DasReyxr/RF-Car/readme.md

# RF-Car

A car
## Directory structure
```
├── design
│   ├── KicadDesign
│   │   ├── Design.kicad_pcb
│   │   ├── Design.kicad_pro
│   │   ├── Design.kicad_sch
│   └── Schematic.pdf
├── doc
│   ├── AC
│   ├── ConfigAC.tex
│   ├── Examen1.pdf
│   ├── Examen1.tex
│   └── Tarjeta didáctica de control para tiristores.pdf
├── README.md
├── src
│   └── render.png
├── sim
│   └── SCR.asc
```

- `SCRController.kicad_sch` / `.kicad_pcb` / `.kicad_pro` — KiCad design
- `SCRController.step` — 3D model
- `Tarjeta didáctica de control para tiristores.pdf` — design writeup
- `simulation.asc.txt` — LTspice simulation

3D render

**Photos of the built board — coming soon**

## Files

## Credit
Built as coursework with [DasReyxr](https://github.com/DasReyxr)  and [Kevin Lara](https://github.com/Gyonyu) — original project history in [DasReyxr/HW-Projects](https://github.com/DasReyxr/HW-Projects). This copy is curated separately with a proper writeup and renders.

## Template
```
mkdir code design doc scripts sim src
```

```
tree >> README.md
```
