DasReyxr/RF-Car/design/TX_Hand/readme.md

# Log File
## 6-29-26
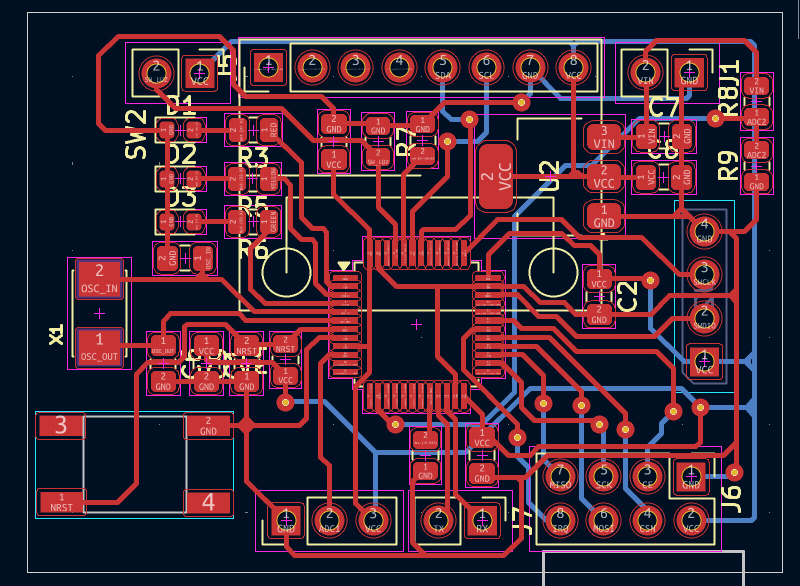
[picture p1: design/TX_Hand/src/readme/image-1.png]

## 6-29-26
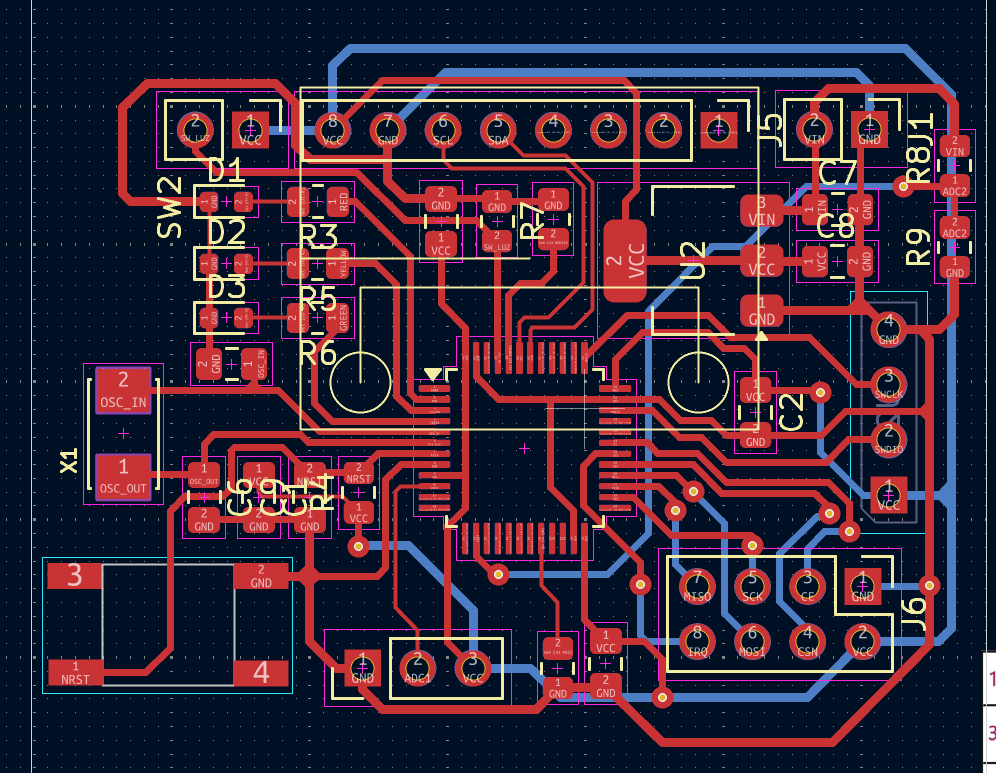
[picture p2: design/TX_Hand/src/readme/image.png]

## 6-29-26
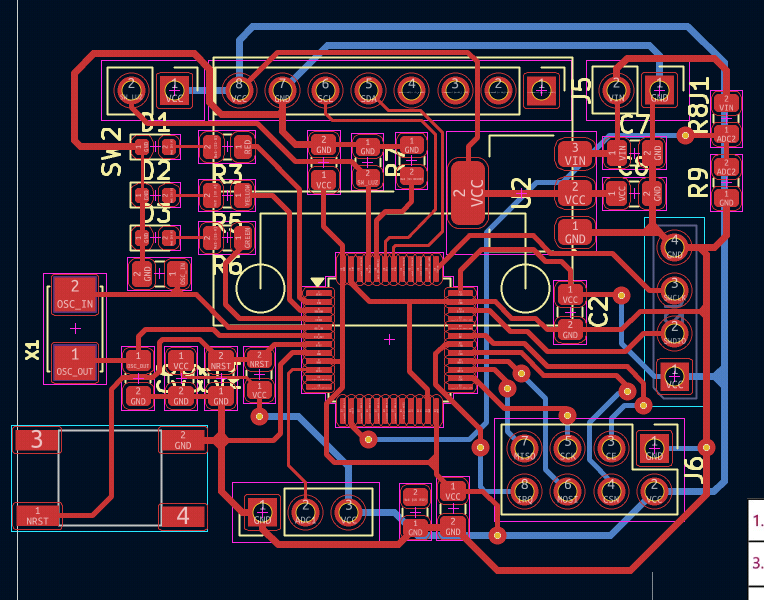
[picture p3: design/TX_Hand/src/readme/6-29-26.png]

## 6-24-26
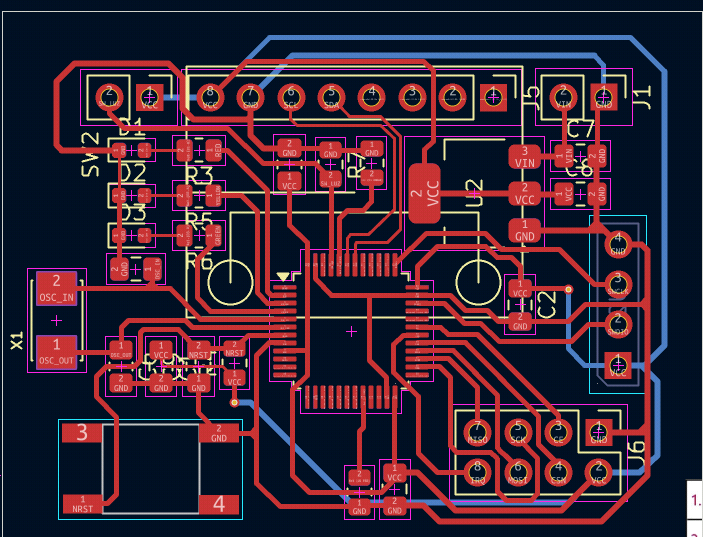
[picture p4: design/TX_Hand/src/readme/6-24-26.png]

## 6-23-26
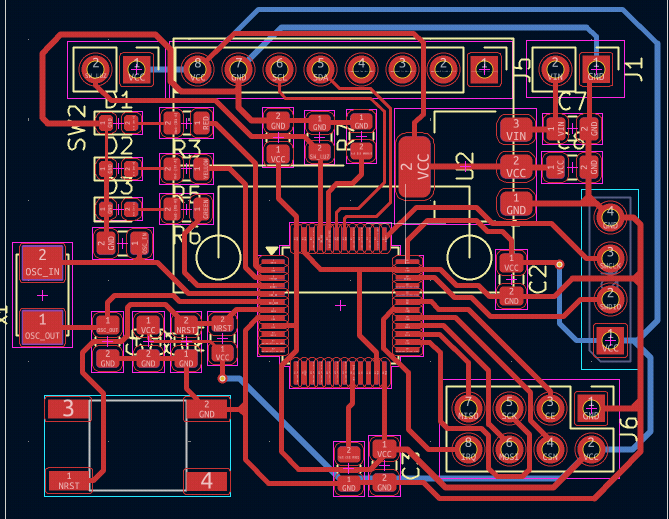
[picture p5: design/TX_Hand/src/readme/6-23-26.png]

# 8-27-26
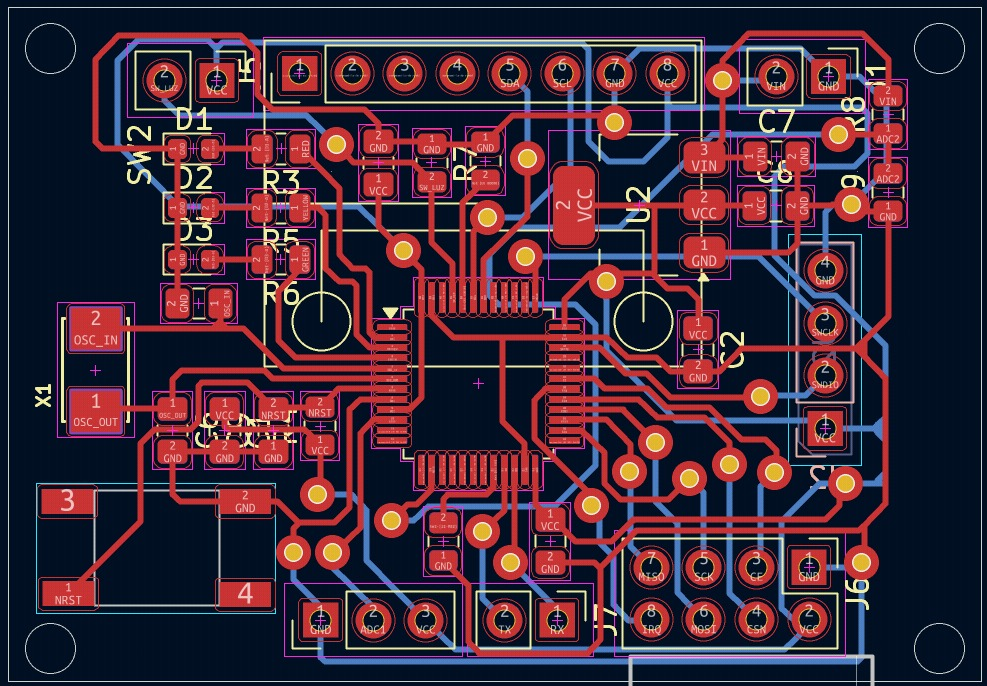
[picture p6: design/TX_Hand/src/readme/image-2.png]


# 10-10-26
- Changed footprints
- Attempt to do it in one layer
- Unconnected VCC and RF mod
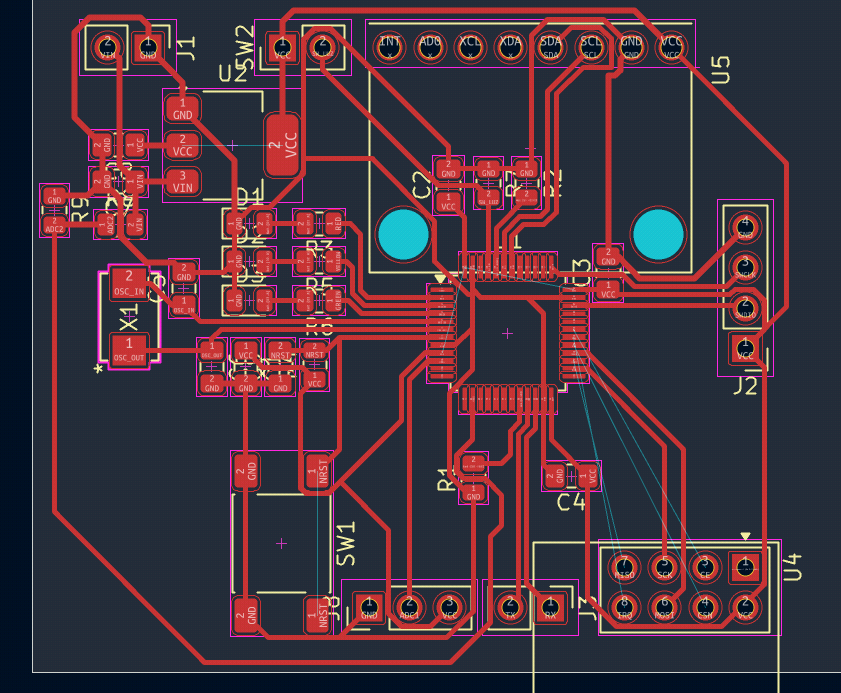
[picture p7: design/TX_Hand/src/readme/image-3.png]

# 10- 11-26
- Autoroute best try (Still not working)
- VCC, SW_Luz and GND not connectedº
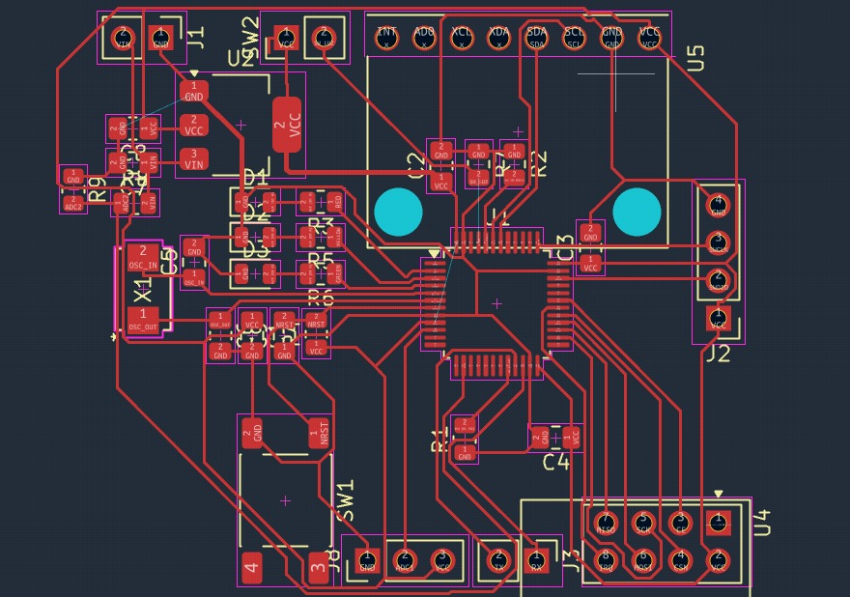
[picture p8: design/TX_Hand/src/readme/image-4.png]
