DasReyxr/RF-Car/code/readme.md

# IOC Config
# RX_Car
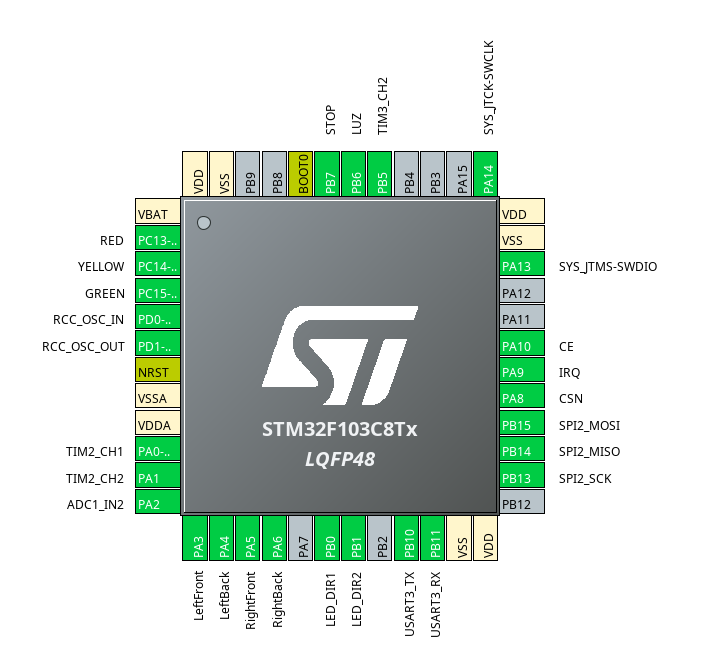
[picture p17: code/src/readme/image.png]

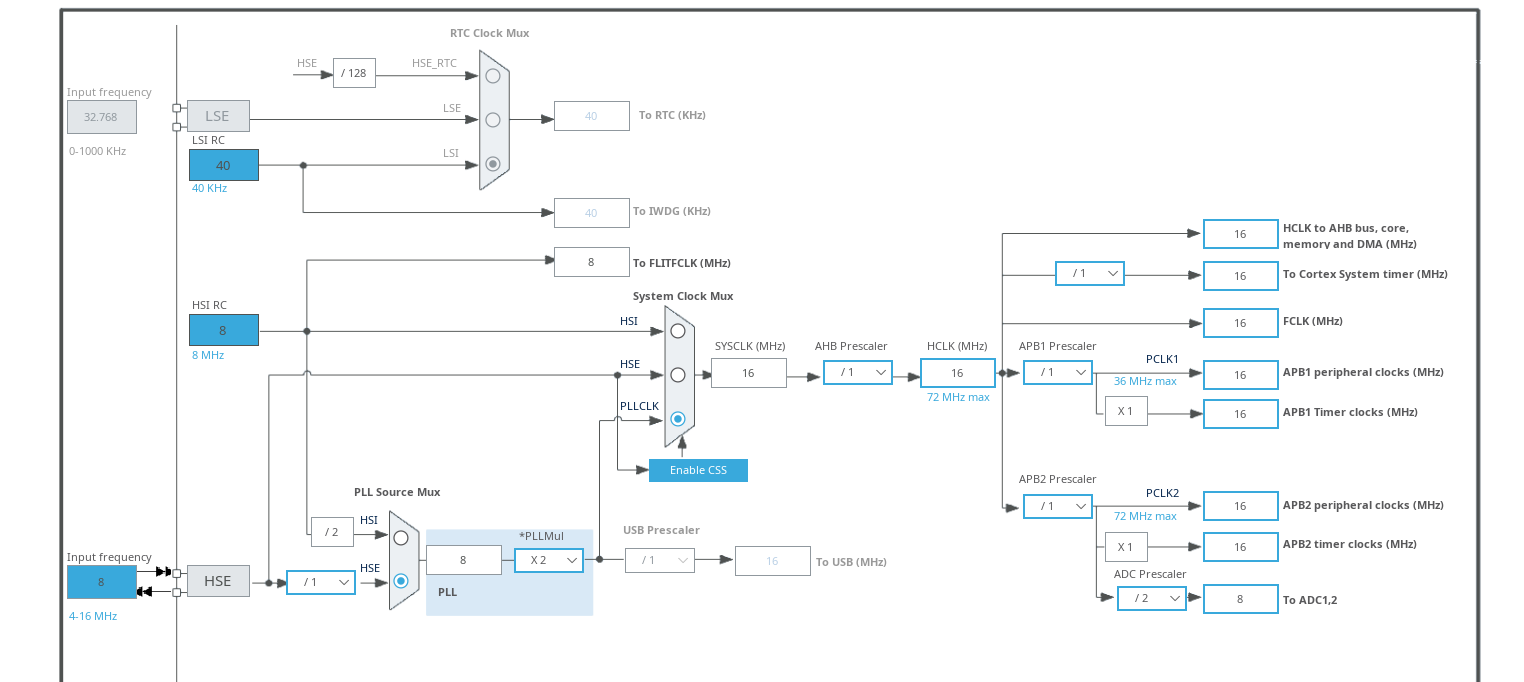
[picture p18: code/src/readme/image-1.png]


# TX_Hand
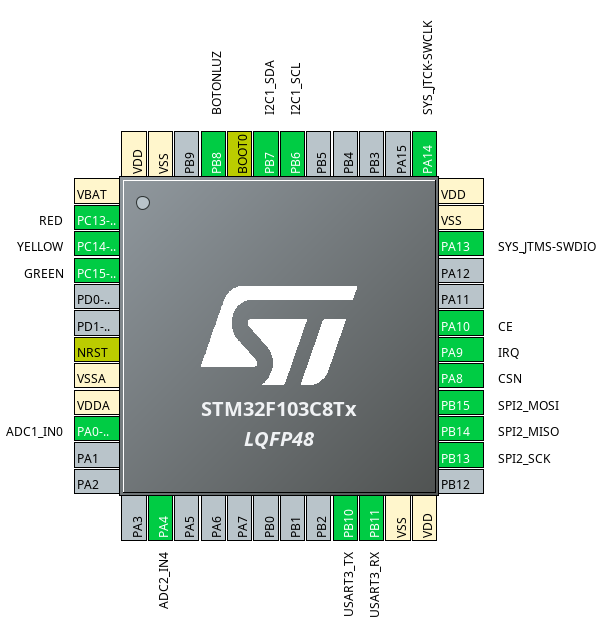
[picture p19: code/src/readme/image-2.png]

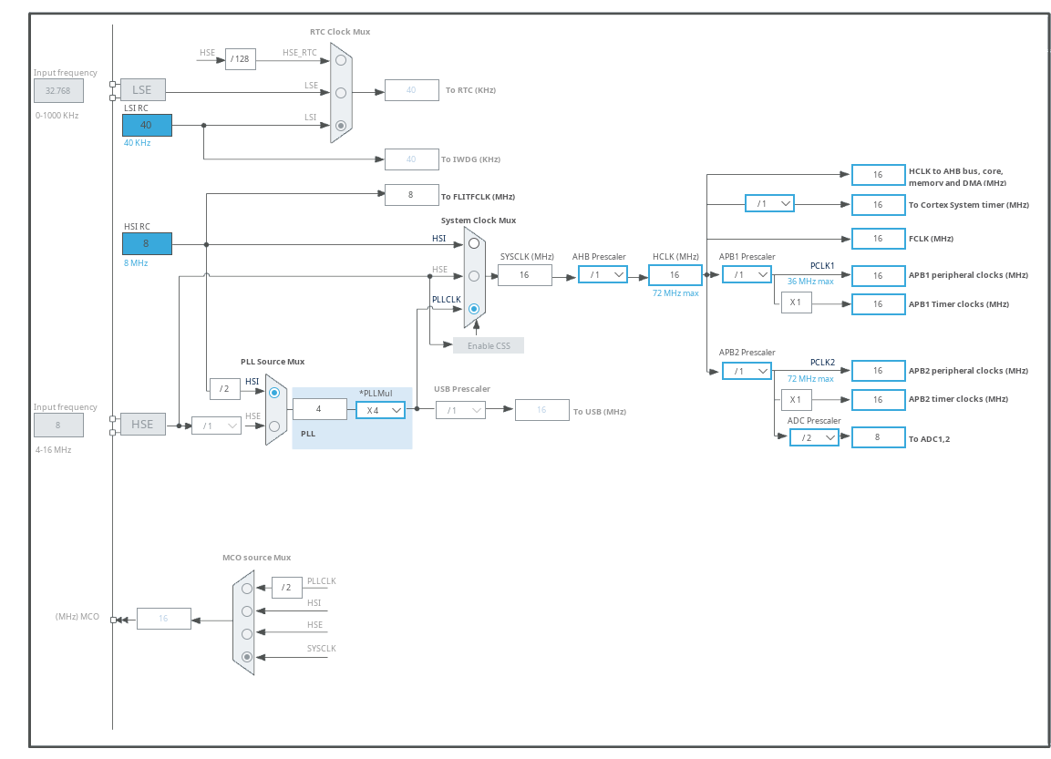
[picture p20: code/src/readme/image-3.png]
