DasReyxr/RF-Car/design/roberikevin/HW_PCB/Librerias/GY-521/GY-521.step

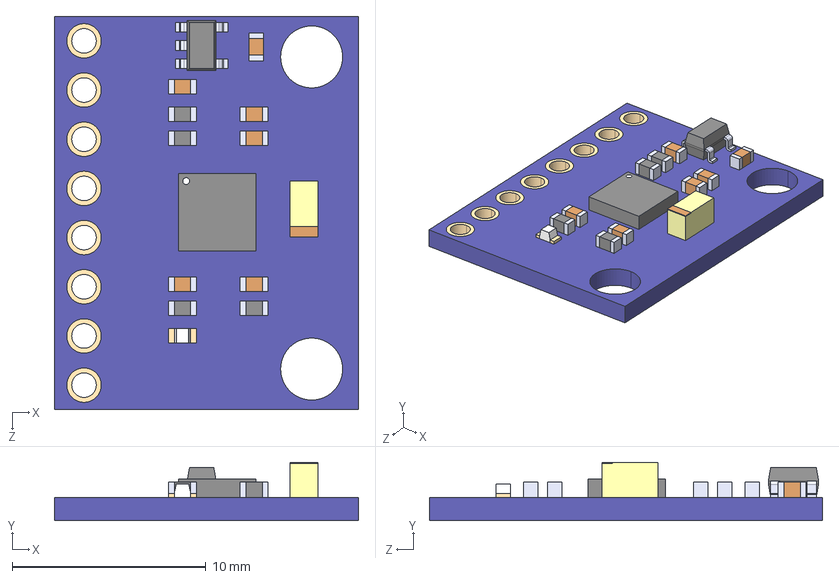
[picture p24: CAD file, 2026-10-10]
design/roberikevin/HW_PCB/Librerias/GY-521/GY-521.step
15.7 x 3.00 x 20.3 mm
