DasReyxr/RF-Car/design/roberikevin/HW_PCB/Librerias/MPU6050/6050_MPU_r0.step

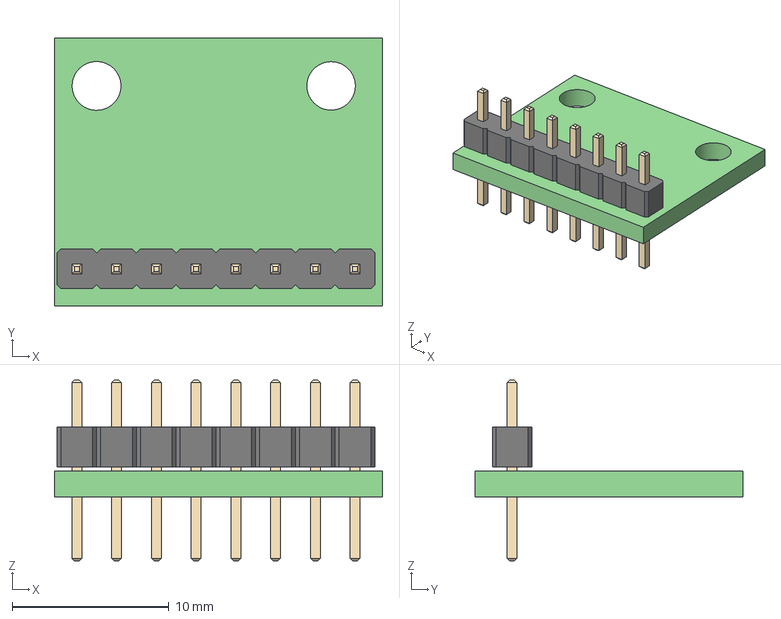
[picture p25: CAD file, 2026-10-10]
design/roberikevin/HW_PCB/Librerias/MPU6050/6050_MPU_r0.step
21.0 x 17.1 x 11.5 mm
