DasReyxr/RF-Car/design/roberikevin/HW_PCB/Librerias/TAJB226K016RNJ/TAJB226K016RNJ.step

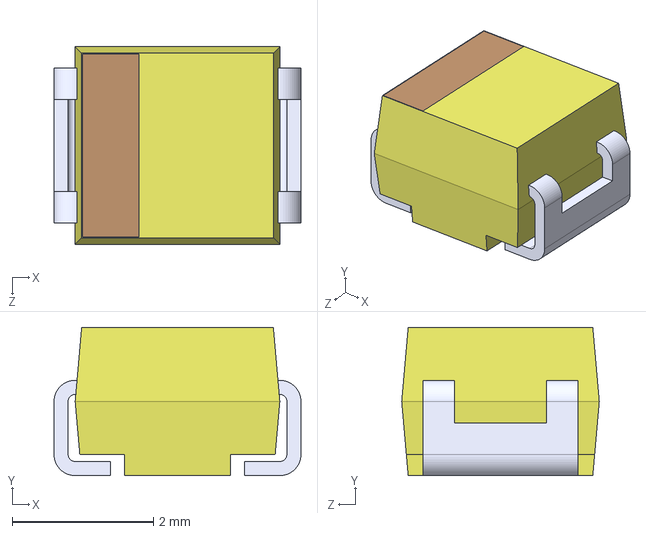
[picture p26: CAD file, 2026-10-10]
design/roberikevin/HW_PCB/Librerias/TAJB226K016RNJ/TAJB226K016RNJ.step
3.50 x 2.10 x 2.80 mm
