DasReyxr/RF-Car/design/roberikevin/HW_PCB/Librerias/TB6612FNG/TB6612FNG.step

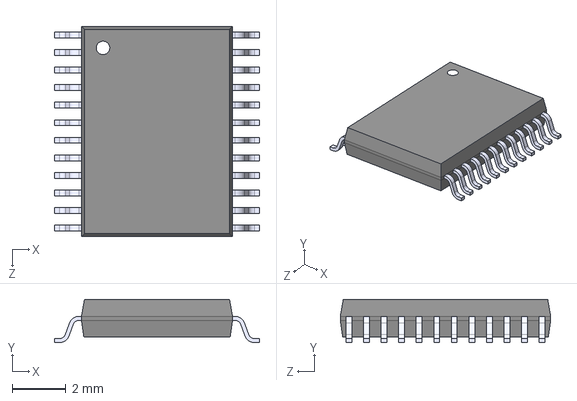
[picture p27: CAD file, 2026-10-10]
design/roberikevin/HW_PCB/Librerias/TB6612FNG/TB6612FNG.step
7.60 x 1.60 x 7.80 mm
