DasReyxr/RF-Car/design/TX_Hand/TX_Hand.kicad_pcb

## KiCad design design/TX_Hand/TX_Hand.kicad_pcb (2026-10-25)

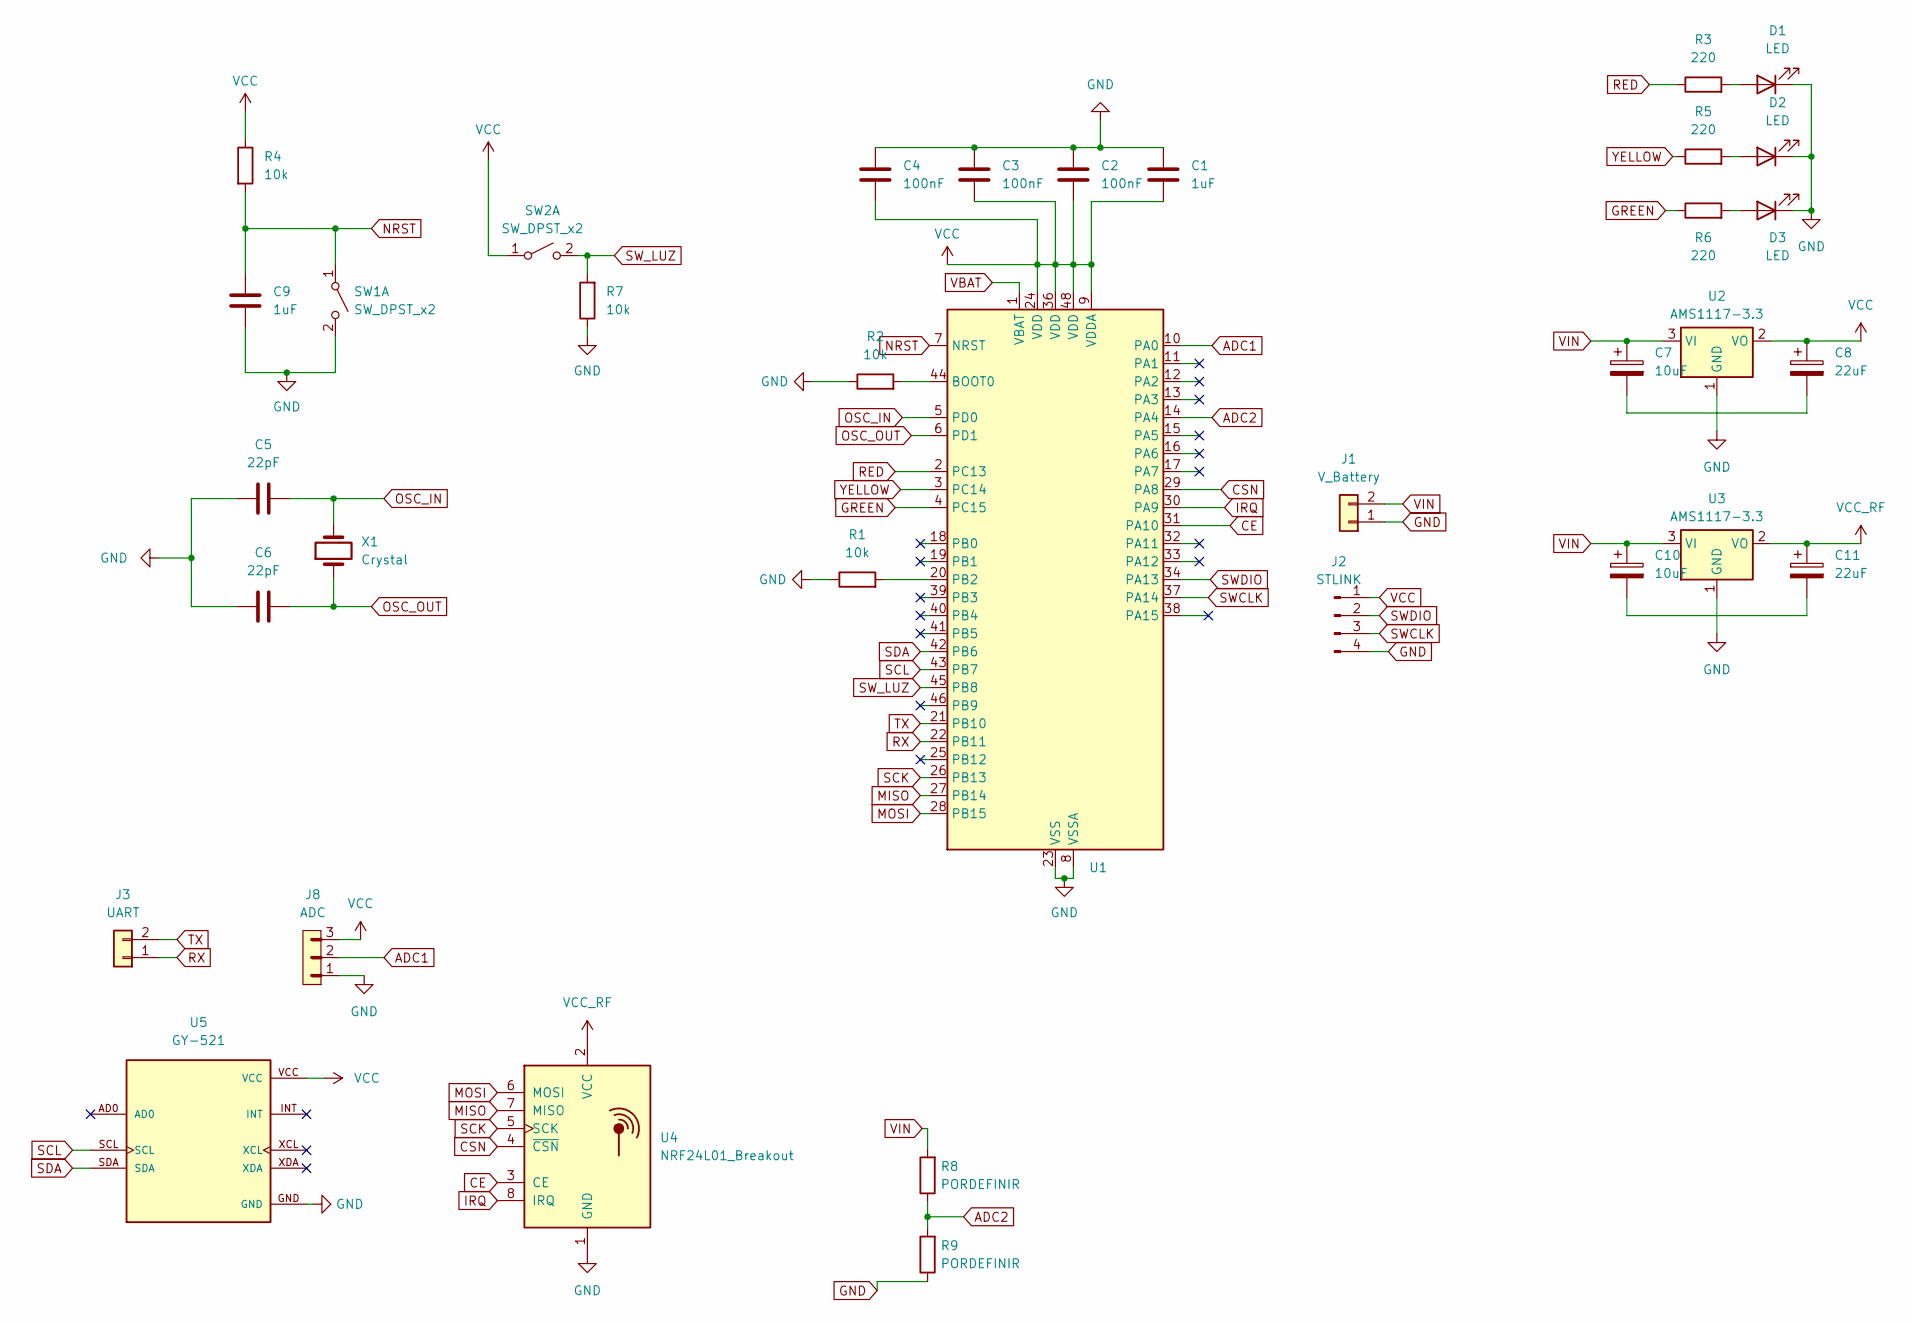
[picture p28: schematic TX_Hand.kicad_sch]

Parts:
C1, C9: 1uF; C_0805_2012Metric_Pad1.18x1.45mm_HandSolder
C2, C3, C4: 100nF; C_0805_2012Metric_Pad1.18x1.45mm_HandSolder
C5, C6: 22pF; C_0805_2012Metric_Pad1.18x1.45mm_HandSolder
C7, C10: 10uF; C_0805_2012Metric_Pad1.18x1.45mm_HandSolder
C8, C11: 22uF; C_0805_2012Metric_Pad1.18x1.45mm_HandSolder
D1, D2, D3: LED; LED_0805_2012Metric
J1: V_Battery; PinHeader_1x02_P2.54mm_Vertical
J2: STLINK; PinHeader_1x04_P2.54mm_Vertical
J3: UART; PinHeader_1x02_P2.54mm_Vertical
J8: ADC; PinHeader_1x03_P2.54mm_Vertical
R1, R2, R4, R7: 10k; R_0805_2012Metric
R3, R5, R6: 220; R_0805_2012Metric
R8, R9: PORDEFINIR; R_0805_2012Metric
SW1: SW_DPST_x2; SW_Push_1P1T_NO_E-Switch_TL3301NxxxxxG
SW2: SW_DPST_x2; PinHeader_1x02_P2.54mm_Vertical
U1: STM32F103C8Tx; LQFP-48_7x7mm_P0.5mm
U2, U3: AMS1117-3.3; SOT-223-3_TabPin2
U4: NRF24L01_Breakout; nRF24L01_Breakout
U5: GY-521; MODULE_GY-521; PARTREV NA
X1: Crystal; XTAL_NX5032_NDK

Connections:
ADC1: J8.2, U1.10 (PA0)
ADC2: R8.1, R9.2, U1.14 (PA4)
CE: U1.31 (PA10), U4.3 (CE)
CSN: U1.29 (PA8), U4.4 (~CSN)
GND: C1.2, C2.2, C3.2, C4.2, C5.2, C6.2, C9.1, D1.1 (K), D2.1 (K), D3.1 (K), J1.1, J2.4, J8.1, R1.1, R2.1, R7.1, R9.1, SW1.2 (B), U1.8 (VSSA), U1.23 (VSS), U1.35 (VSS), U1.47 (VSS), U2.1 (GND), U3.1 (GND), U4.1 (GND), U5.GND
GREEN: R6.1, U1.4 (PC15)
IRQ: U1.30 (PA9), U4.8 (IRQ)
MISO: U1.27 (PB14), U4.7 (MISO)
MOSI: U1.28 (PB15), U4.6 (MOSI)
NRST: C9.2, R4.2, SW1.1 (A), U1.7 (NRST)
unnamed: C7.2, C8.2
unnamed: C10.2, C11.2
unnamed: D1.2 (A), R3.2
unnamed: D2.2 (A), R5.2
unnamed: D3.2 (A), R6.2
unnamed: R2.2, U1.44 (BOOT0)
unnamed: R1.2, U1.20 (PB2)
OSC_IN: C5.1, U1.5 (PD0), X1.2
OSC_OUT: C6.1, U1.6 (PD1), X1.1
RED: R3.1, U1.2 (PC13)
RX: J3.1, U1.22 (PB11)
SCK: U1.26 (PB13), U4.5 (SCK)
SCL: U1.43 (PB7), U5.SCL
SDA: U1.42 (PB6), U5.SDA
SWCLK: J2.3, U1.37 (PA14)
SWDIO: J2.2, U1.34 (PA13)
SW_LUZ: R7.2, SW2.2 (B), U1.45 (PB8)
TX: J3.2, U1.21 (PB10)
VBAT: U1.1 (VBAT)
VCC: C1.1, C2.1, C3.1, C4.1, C8.1, J2.1, J8.3, R4.1, SW2.1 (A), U1.9 (VDDA), U1.24 (VDD), U1.36 (VDD), U1.48 (VDD), U2.2 (VO), U5.VCC
VCC_RF: C11.1, U3.2 (VO), U4.2 (VCC)
VIN: C7.1, C10.1, J1.2, R8.2, U2.3 (VI), U3.3 (VI)
YELLOW: R5.1, U1.3 (PC14)

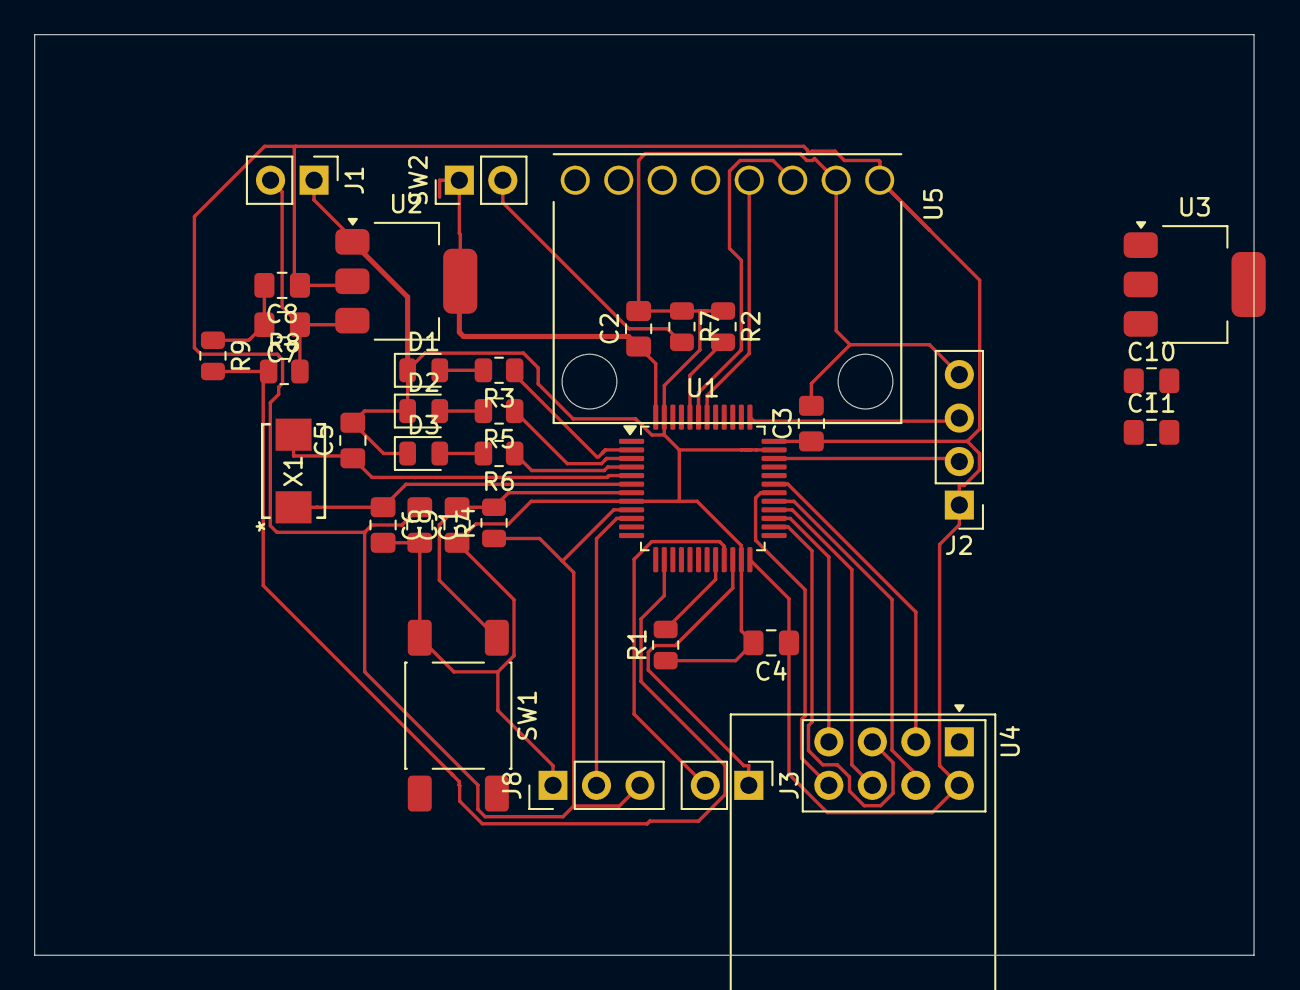
[picture p29: board TX_Hand.kicad_pcb from above]

Board: 2 copper layers, 71.2 x 53.8 mm, 35 parts (0 on the bottom side), 32 nets.
