DasReyxr/RF-Car/design/roberikevin/HW_PCB/CAR/carro_preliminar/carro_preliminar.kicad_pcb

## KiCad design design/roberikevin/HW_PCB/CAR/carro_preliminar/carro_preliminar.kicad_pcb (2026-10-10)

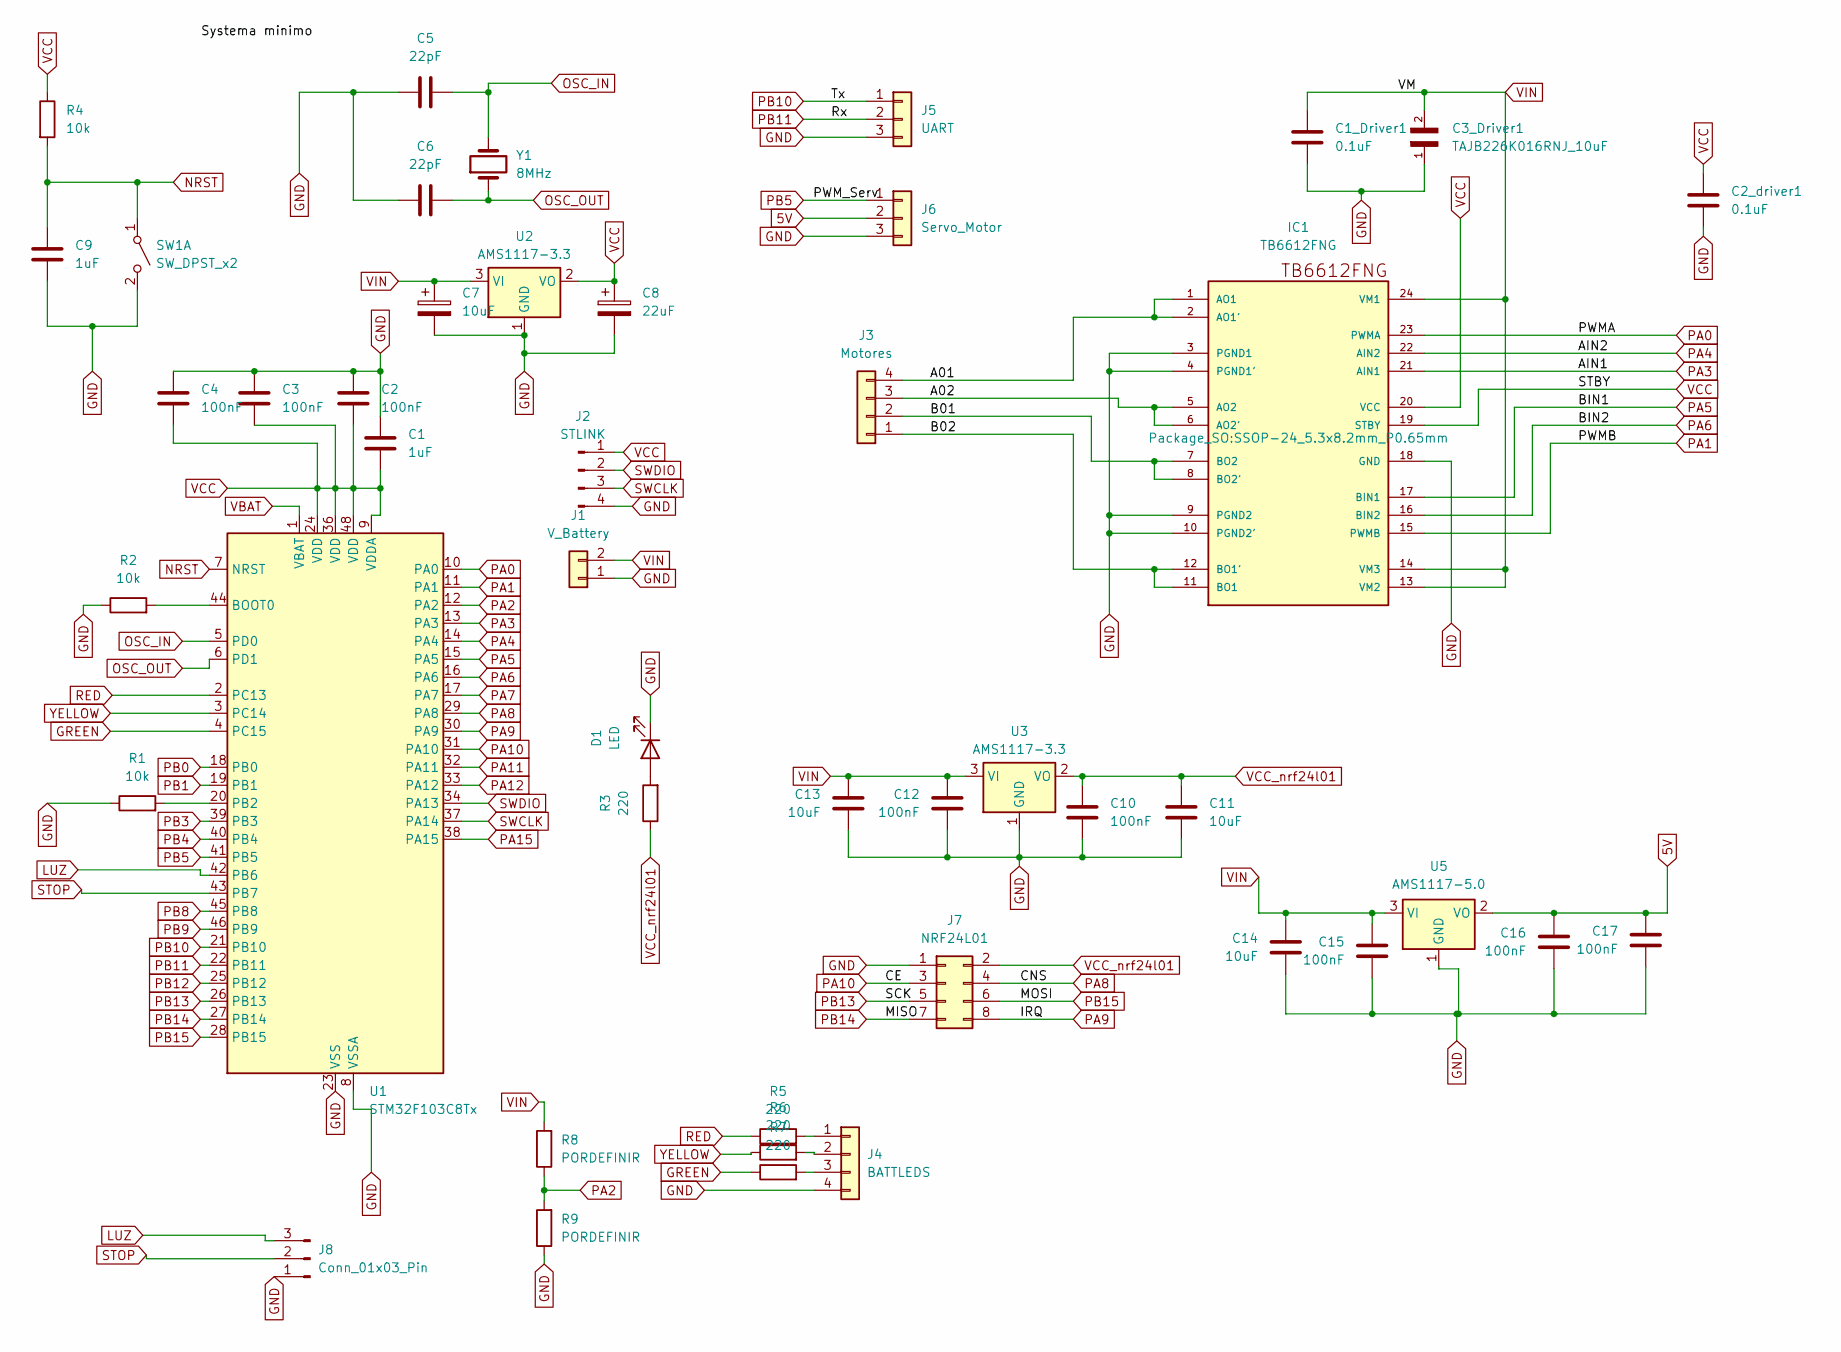
[picture p30: schematic carro_preliminar.kicad_sch]

Parts:
C1: 1uF; C_0805_2012Metric
C1_Driver1, C2_driver1: 0.1uF; C_0805_2012Metric
C2, C3, C4, C10, C12, C15, C16, C17: 100nF; C_0805_2012Metric_Pad1.18x1.45mm_HandSolder
C3_Driver1: TAJB226K016RNJ_10uF; CAPPC3528X210N; DigiKey_Part_Number 478-1682-1-ND
C5, C6: 22pF; C_0805_2012Metric_Pad1.18x1.45mm_HandSolder
C7, C11, C13, C14: 10uF; C_0805_2012Metric_Pad1.18x1.45mm_HandSolder
C8: 22uF; C_0805_2012Metric_Pad1.18x1.45mm_HandSolder
C9: 1uF; C_0805_2012Metric_Pad1.18x1.45mm_HandSolder
D1: LED; LED_0603_1608Metric
IC1: TB6612FNG; SSOP-24_5.3x8.2mm_P0.65mm
J1: V_Battery; PinHeader_1x02_P2.54mm_Vertical
J2: STLINK; PinHeader_1x04_P2.54mm_Vertical
J3: Motores; PinHeader_1x04_P2.54mm_Vertical
J4: BATTLEDS; PinHeader_1x04_P2.54mm_Vertical
J5: UART; PinHeader_1x03_P2.54mm_Vertical
J6: Servo_Motor; PinHeader_1x03_P2.54mm_Vertical
J7: NRF24L01; PinHeader_2x04_P2.54mm_Vertical
J8: Conn_01x03_Pin; PinHeader_1x03_P2.54mm_Vertical
R1, R2, R4: 10k; R_0805_2012Metric
R3, R5, R6, R7: 220; R_0805_2012Metric
R8, R9: PORDEFINIR; R_0805_2012Metric
SW1: SW_DPST_x2; Untitled
U1: STM32F103C8Tx; LQFP-48_7x7mm_P0.5mm
U2, U3: AMS1117-3.3; SOT-223-3_TabPin2
U5: AMS1117-5.0; SOT-223-3_TabPin2
Y1: 8MHz; XTAL_NX5032GA-8.000M-STD-CSU-1

Connections:
5V: C16.1, C17.1, J6.2, U5.2 (VO)
/A01: IC1.1 (AO1), IC1.2 (AO1'), J3.4
/A02: IC1.5 (AO2), IC1.6 (AO2'), J3.3
/B01: IC1.7 (BO2), IC1.8 (BO2'), J3.2
/B02: IC1.11 (BO1), IC1.12 (BO1'), J3.1
GND: C1.2, C1_Driver1.2, C2.2, C2_driver1.2, C3.2, C3_Driver1.1, C4.2, C5.2, C6.2, C7.2, C8.2, C9.1, C10.2, C11.2, C12.2, C13.2, C14.2, C15.2, C16.2, C17.2, D1.1 (K), IC1.3 (PGND1), IC1.4 (PGND1'), IC1.9 (PGND2), IC1.10 (PGND2'), IC1.18 (GND), J1.1, J2.4, J4.4, J5.3, J6.3, J7.1, J8.1, R1.1, R2.1, R9.1, SW1.2 (B), U1.8 (VSSA), U1.23 (VSS), U1.35 (VSS), U1.47 (VSS), U2.1 (GND), U3.1 (GND), U5.1 (GND)
GREEN: R7.1, U1.4 (PC15)
LUZ: J8.3, U1.42 (PB6)
NRST: C9.2, R4.2, SW1.1 (A), U1.7 (NRST)
unnamed: D1.2 (A), R3.2
unnamed: J4.1, R5.2
unnamed: J4.2, R6.2
unnamed: J4.3, R7.2
unnamed: R2.2, U1.44 (BOOT0)
unnamed: R1.2, U1.20 (PB2)
OSC_IN: C5.1, U1.5 (PD0), Y1.2
OSC_OUT: C6.1, U1.6 (PD1), Y1.1
PA0: IC1.23 (PWMA), U1.10 (PA0)
PA1: IC1.15 (PWMB), U1.11 (PA1)
PA2: R8.1, R9.2, U1.12 (PA2)
PA3: IC1.21 (AIN1), U1.13 (PA3)
PA4: IC1.22 (AIN2), U1.14 (PA4)
PA5: IC1.17 (BIN1), U1.15 (PA5)
PA6: IC1.16 (BIN2), U1.16 (PA6)
PA7: U1.17 (PA7)
PA8: J7.4, U1.29 (PA8)
PA9: J7.8, U1.30 (PA9)
PA10: J7.3, U1.31 (PA10)
PA11: U1.32 (PA11)
PA12: U1.33 (PA12)
PA15: U1.38 (PA15)
PB0: U1.18 (PB0)
PB1: U1.19 (PB1)
PB3: U1.39 (PB3)
PB4: U1.40 (PB4)
PB5: J6.1, U1.41 (PB5)
PB8: U1.45 (PB8)
PB9: U1.46 (PB9)
PB10: J5.1, U1.21 (PB10)
PB11: J5.2, U1.22 (PB11)
PB12: U1.25 (PB12)
PB13: J7.5, U1.26 (PB13)
PB14: J7.7, U1.27 (PB14)
PB15: J7.6, U1.28 (PB15)
RED: R5.1, U1.2 (PC13)
STOP: J8.2, U1.43 (PB7)
SWCLK: J2.3, U1.37 (PA14)
SWDIO: J2.2, U1.34 (PA13)
VBAT: U1.1 (VBAT)
VCC: C1.1, C2.1, C2_driver1.1, C3.1, C4.1, C8.1, IC1.19 (STBY), IC1.20 (VCC), J2.1, R4.1, U1.9 (VDDA), U1.24 (VDD), U1.36 (VDD), U1.48 (VDD), U2.2 (VO)
VCC_nrf24l01: C10.1, C11.1, J7.2, R3.1, U3.2 (VO)
VIN: C1_Driver1.1, C3_Driver1.2, C7.1, C12.1, C13.1, C14.1, C15.1, IC1.13 (VM2), IC1.14 (VM3), IC1.24 (VM1), J1.2, R8.2, U2.3 (VI), U3.3 (VI), U5.3 (VI)
YELLOW: R6.1, U1.3 (PC14)

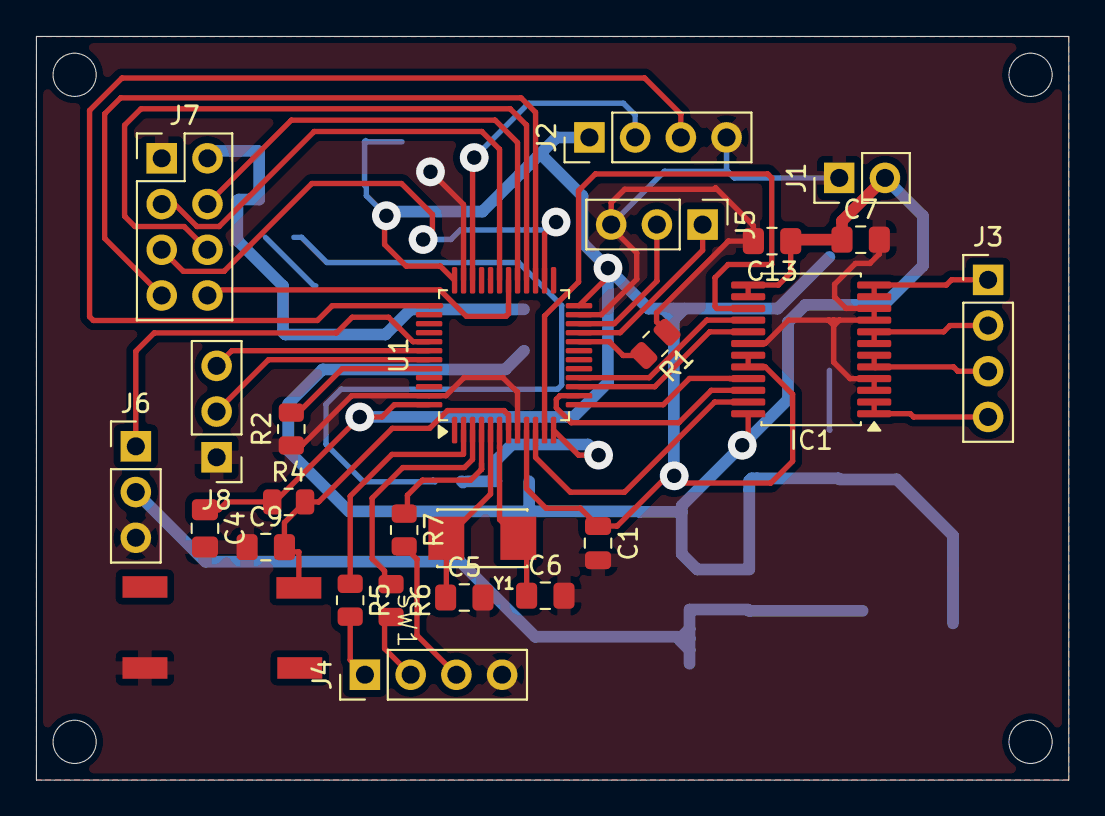
[picture p31: board carro_preliminar.kicad_pcb from above]

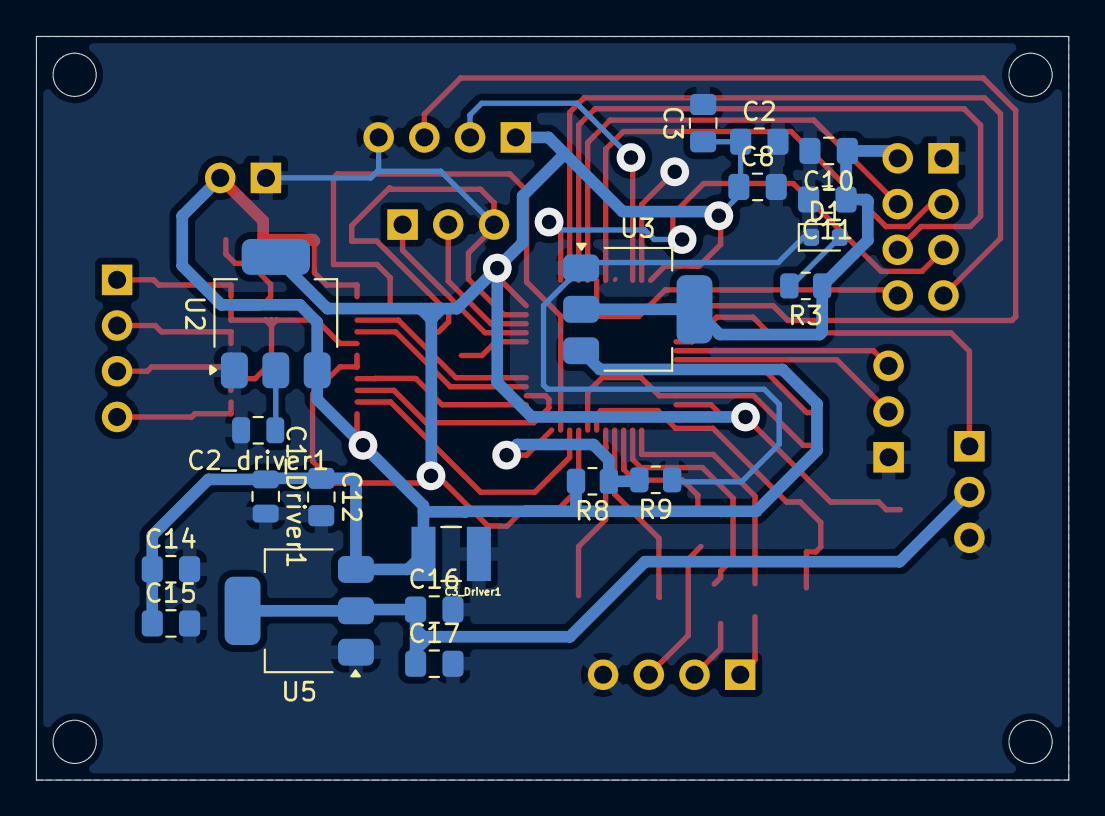
[picture p32: board carro_preliminar.kicad_pcb from below]

Board: 2 copper layers, 57.4 x 41.3 mm, 45 parts (20 on the bottom side), 41 nets.
