DasReyxr/RF-Car/design/roberikevin/HW_PCB/SYS_MIN/Blue_pill/Blue_pill.kicad_pcb

## KiCad design design/roberikevin/HW_PCB/SYS_MIN/Blue_pill/Blue_pill.kicad_pcb (2026-10-10)

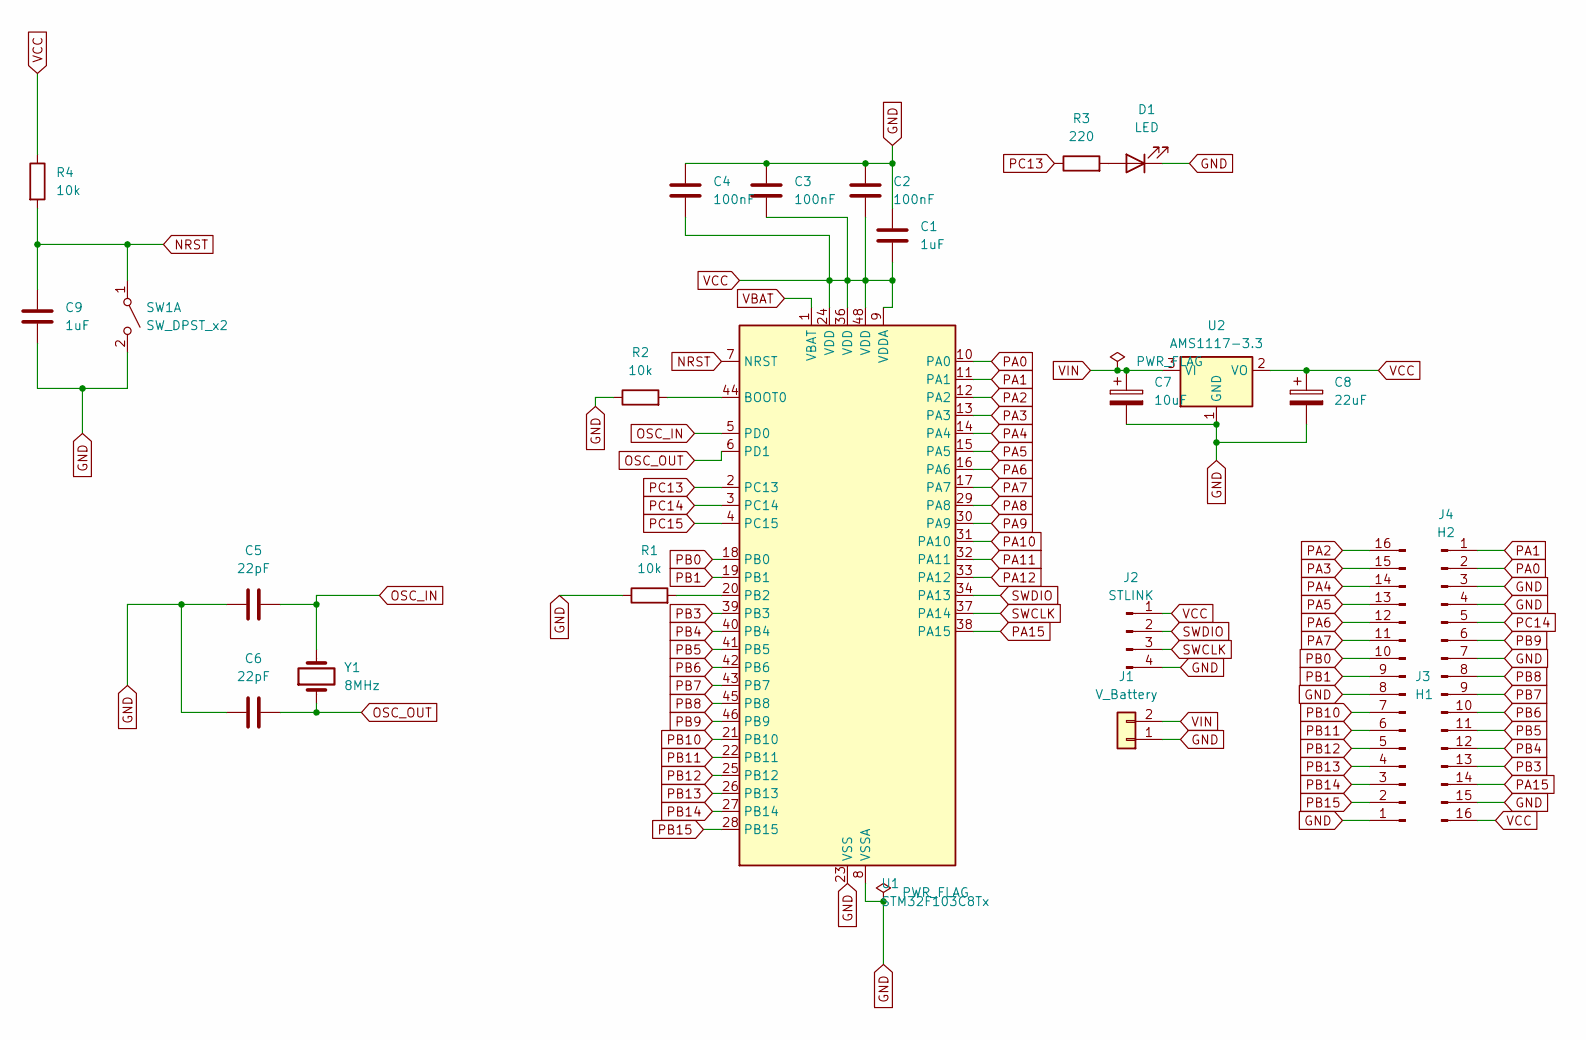
[picture p33: schematic Blue_pill.kicad_sch]

Parts:
C1: 1uF; C_0805_2012Metric
C2, C3, C4: 100nF; C_0805_2012Metric_Pad1.18x1.45mm_HandSolder
C5, C6: 22pF; C_0805_2012Metric_Pad1.18x1.45mm_HandSolder
C7: 10uF; C_0805_2012Metric_Pad1.18x1.45mm_HandSolder
C8: 22uF; C_0805_2012Metric_Pad1.18x1.45mm_HandSolder
C9: 1uF; C_0805_2012Metric_Pad1.18x1.45mm_HandSolder
D1: LED; LED_0603_1608Metric
J1: V_Battery; PinHeader_1x02_P2.54mm_Vertical
J2: STLINK; PinHeader_1x04_P2.54mm_Vertical
J3: H1; PinHeader_1x16_P2.54mm_Vertical
J4: H2; PinHeader_1x16_P2.54mm_Vertical
R1, R2, R4: 10k; R_0805_2012Metric
R3: 220; R_0805_2012Metric
SW1: SW_DPST_x2; Untitled
U1: STM32F103C8Tx; LQFP-48_7x7mm_P0.5mm
U2: AMS1117-3.3; SOT-223-3_TabPin2
Y1: 8MHz; Crystal_SMD_EuroQuartz_MQ2-2Pin_7.0x5.0mm

Connections:
GND: C1.2, C2.2, C3.2, C4.2, C5.2, C6.2, C7.2, C8.2, C9.1, D1.1 (K), J1.1, J2.4, J3.1, J3.8, J4.3, J4.4, J4.7, J4.15, R1.1, R2.1, SW1.2 (B), U1.8 (VSSA), U1.23 (VSS), U1.35 (VSS), U1.47 (VSS), U2.1 (GND)
NRST: C9.2, R4.2, SW1.1 (A), U1.7 (NRST)
unnamed: D1.2 (A), R3.2
unnamed: R2.2, U1.44 (BOOT0)
unnamed: R1.2, U1.20 (PB2)
OSC_IN: C5.1, U1.5 (PD0), Y1.2
OSC_OUT: C6.1, U1.6 (PD1), Y1.1
PA0: J4.2, U1.10 (PA0)
PA1: J4.1, U1.11 (PA1)
PA2: J3.16, U1.12 (PA2)
PA3: J3.15, U1.13 (PA3)
PA4: J3.14, U1.14 (PA4)
PA5: J3.13, U1.15 (PA5)
PA6: J3.12, U1.16 (PA6)
PA7: J3.11, U1.17 (PA7)
PA8: U1.29 (PA8)
PA9: U1.30 (PA9)
PA10: U1.31 (PA10)
PA11: U1.32 (PA11)
PA12: U1.33 (PA12)
PA15: J4.14, U1.38 (PA15)
PB0: J3.10, U1.18 (PB0)
PB1: J3.9, U1.19 (PB1)
PB3: J4.13, U1.39 (PB3)
PB4: J4.12, U1.40 (PB4)
PB5: J4.11, U1.41 (PB5)
PB6: J4.10, U1.42 (PB6)
PB7: J4.9, U1.43 (PB7)
PB8: J4.8, U1.45 (PB8)
PB9: J4.6, U1.46 (PB9)
PB10: J3.7, U1.21 (PB10)
PB11: J3.6, U1.22 (PB11)
PB12: J3.5, U1.25 (PB12)
PB13: J3.4, U1.26 (PB13)
PB14: J3.3, U1.27 (PB14)
PB15: J3.2, U1.28 (PB15)
PC13: R3.1, U1.2 (PC13)
PC14: J4.5, U1.3 (PC14)
PC15: U1.4 (PC15)
SWCLK: J2.3, U1.37 (PA14)
SWDIO: J2.2, U1.34 (PA13)
VBAT: U1.1 (VBAT)
VCC: C1.1, C2.1, C3.1, C4.1, C8.1, J2.1, J4.16, R4.1, U1.9 (VDDA), U1.24 (VDD), U1.36 (VDD), U1.48 (VDD), U2.2 (VO)
VIN: C7.1, J1.2, U2.3 (VI)

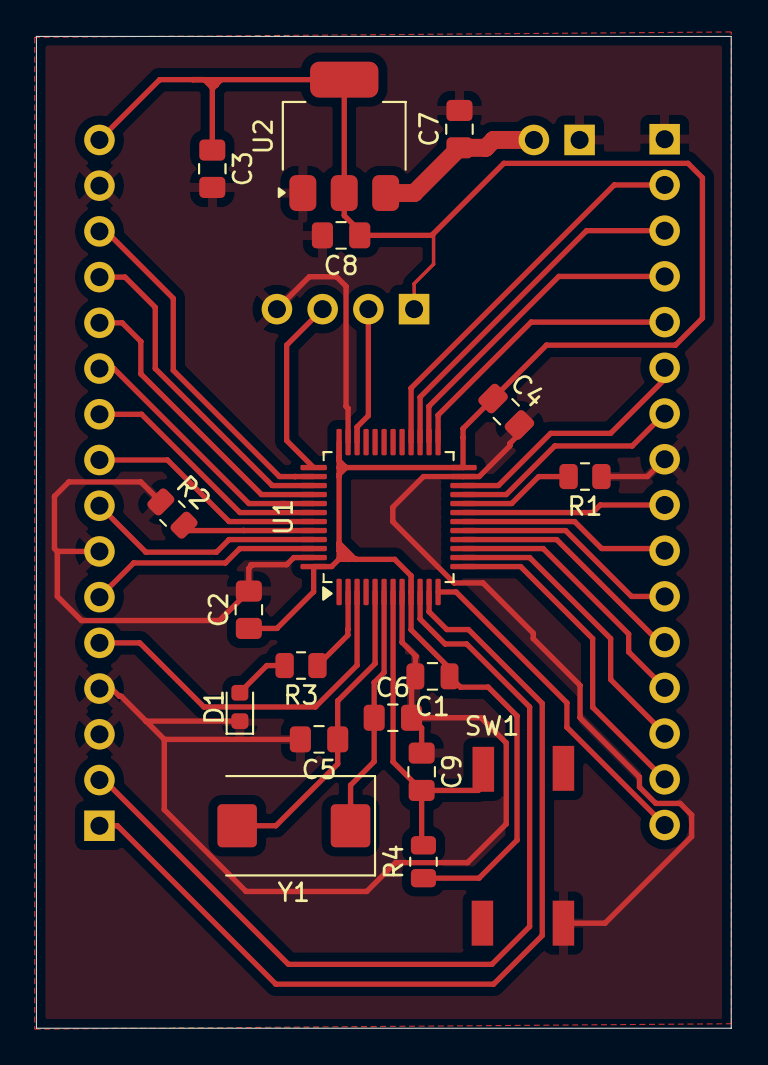
[picture p34: board Blue_pill.kicad_pcb from above]

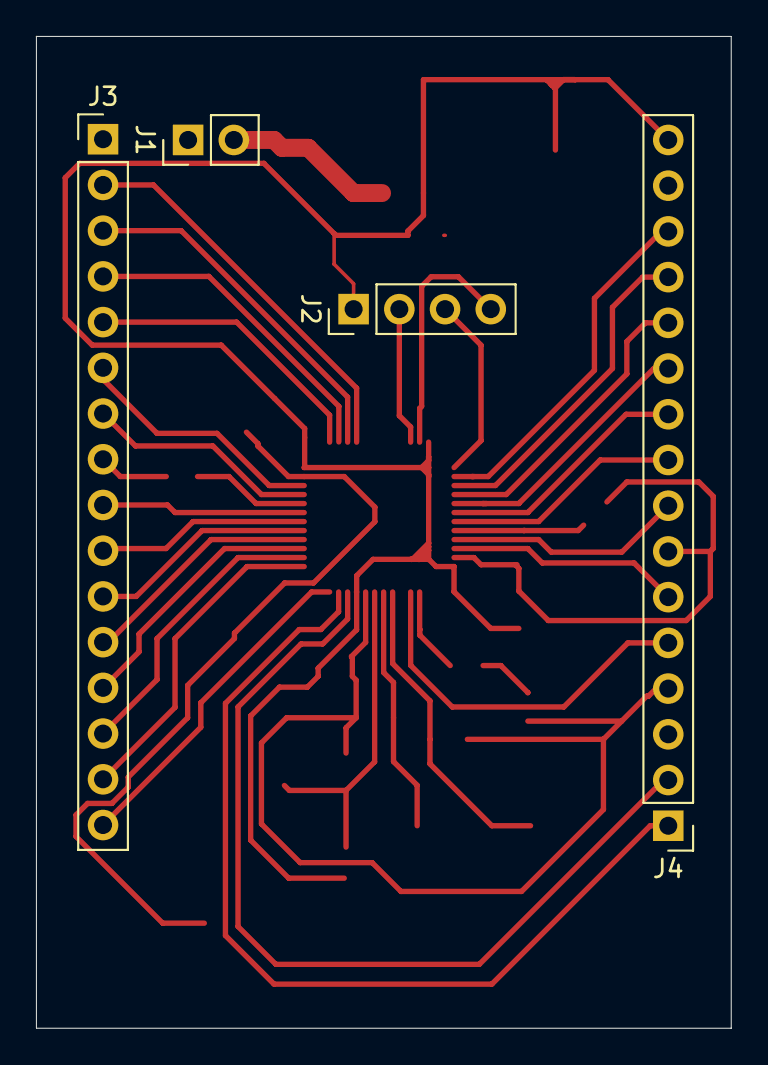
[picture p35: board Blue_pill.kicad_pcb from below]

Board: 2 copper layers, 38.6 x 55.1 mm, 22 parts (4 on the bottom side), 37 nets.
