DasReyxr/RF-Car/design/roberikevin/HW_PCB/CAR/driver_puenteH/driver_puenteH.kicad_pcb

## KiCad design design/roberikevin/HW_PCB/CAR/driver_puenteH/driver_puenteH.kicad_pcb (2026-10-10)

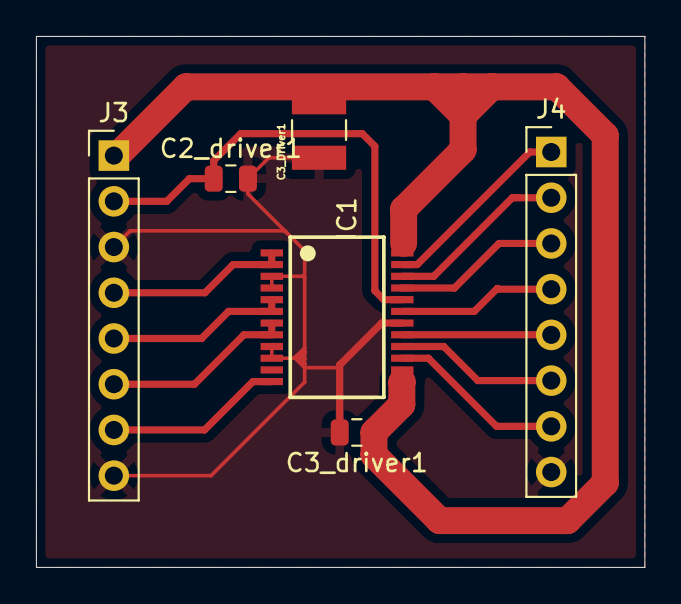
[picture p36: board driver_puenteH.kicad_pcb from above]

Board: 2 copper layers, 33.8 x 29.5 mm, 6 parts (0 on the bottom side), 14 nets.

Parts:
C2_driver1: 0.1uF; C_0805_2012Metric
C3_Driver1: TAJB226K016RNJ_10uF; CAPPC3528X210N
C3_driver1: 10uF; C_0805_2012Metric
IC1: TB6612FNG; SSOP24
J3: Puente H; PinHeader_1x08_P2.54mm_Vertical
J4: Puente_H2; PinHeader_1x08_P2.54mm_Vertical

Connections:
/A01: IC1.1 (AO1), IC1.2 (AO1'), J3.4
/A02: IC1.5 (AO2), IC1.6 (AO2'), J3.5
/AIN1: IC1.21 (AIN1), J4.3
/AIN2: IC1.22 (AIN2), J4.2
/B01: IC1.7 (BO2), IC1.8 (BO2'), J3.6
/B02: IC1.11 (BO1), IC1.12 (BO1'), J3.7
/BIN1: IC1.17 (BIN1), J4.5
/BIN2: IC1.16 (BIN2), J4.6
/PWMA: IC1.23 (PWMA), J4.1
/PWMB: IC1.15 (PWMB), J4.7
/STBY: IC1.19 (STBY), J4.4
/VM: C3_Driver1.2, C3_driver1.1, IC1.13 (VM2), IC1.14 (VM3), IC1.24 (VM1), J3.1
GND: C2_driver1.2, C3_Driver1.1, C3_driver1.2, IC1.3 (PGND1), IC1.4 (PGND1'), IC1.9 (PGND2), IC1.10 (PGND2'), IC1.18 (GND), J3.3, J3.8, J4.8
VCC: C2_driver1.1, IC1.20 (VCC), J3.2
