DasReyxr/RF-Car/code/RX_Car/Core/Src/main.c

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
/* Includes ------------------------------------------------------------------*/
#include "main.h"

/* USER CODE BEGIN Includes */
#include "NRF24.h"
#include "NRF24_reg_addresses.h"
#include "conf.h"
#include <stdio.h>

/* USER CODE END Includes */

/* USER CODE BEGIN PD */
typedef struct {
  uint8_t cmd;
  uint8_t speed;

  float angle;
} RF_Data;

#define PLD_SIZE sizeof(RF_Data)
/* USER CODE END PD */

ADC_HandleTypeDef hadc1;

SPI_HandleTypeDef hspi2;

TIM_HandleTypeDef htim2;
TIM_HandleTypeDef htim3;

UART_HandleTypeDef huart3;

/* USER CODE BEGIN PV */

RF_Data rxData;
uint8_t dataRx[sizeof(RF_Data)];
uint8_t addrRx[5]="juan1";
uint16_t adc_val;
uint16_t batery_val;
/* USER CODE END PV */

void SystemClock_Config(void);
static void MX_GPIO_Init(void);
static void MX_SPI2_Init(void);
static void MX_TIM2_Init(void);
static void MX_TIM3_Init(void);
static void MX_ADC1_Init(void);
static void MX_USART3_UART_Init(void);
/**
  * @brief  The application entry point.
  * @retval int
  */
int main(void)
{

  /* MCU Configuration--------------------------------------------------------*/

  /* Reset of all peripherals, Initializes the Flash interface and the Systick. */
  HAL_Init();

  /* Configure the system clock */
  SystemClock_Config();

  /* Initialize all configured peripherals */
  MX_GPIO_Init();
  MX_SPI2_Init();
  MX_TIM2_Init();
  MX_TIM3_Init();
  MX_ADC1_Init();
  MX_USART3_UART_Init();
  /* USER CODE BEGIN 2 */
  HAL_TIM_PWM_Start(&htim2, TIM_CHANNEL_1); // Start PWM for motor channel 1
  HAL_TIM_PWM_Start(&htim2, TIM_CHANNEL_2); // Start PWM for motor channel 2
  HAL_TIM_PWM_Start(&htim3, TIM_CHANNEL_2); // Start PWM for servo
  csn_high();
  nrf24_init();
  nrf24_tx_pwr(_0dbm );
  nrf24_data_rate(_2mbps);
  nrf24_set_crc(en_crc,_1byte);
  nrf24_set_channel(100);
  nrf24_pipe_pld_size(0,PLD_SIZE);
  //nrf24_open_tx_pipe(addrRx);
  nrf24_open_rx_pipe(0,addrRx);
  nrf24_listen();
  HAL_ADC_Start(&hadc1);




  /* USER CODE END 2 */

  /* Infinite loop */
  /* USER CODE BEGIN WHILE */
  while (1)
  {
    /* USER CODE END WHILE */

    /* USER CODE BEGIN 3 */
    nrf24_listen();
    if(nrf24_data_available()){
        nrf24_receive(dataRx, sizeof(dataRx));
        // Copy received bytes into struct
        memcpy(&rxData, dataRx, sizeof(RF_Data));
        if(rxData.cmd == 0x01)
            CAR_Stop();
            else {
              // --- Direction Motor ---
              if(rxData.cmd == 0x04)      CAR_Back();
              else if(rxData.cmd == 0x02)
            	  CAR_Front();
              uint16_t cast =(uint16_t)rxData.angle;
              __HAL_TIM_SET_COMPARE(&htim3,TIM_CHANNEL_2,cast );
              // --- Speed Motor ---
              CAR_Speed(rxData.speed);
              // -- LED  ---
              if(rxData.cmd == 0x10) GPIOB->ODR ^= (1<<6); // Toggle Light
              }
              /*ADC_BAT*/

              /*UART*/
          /*
          bat = {battery_val}
          cmd = {rxData.cmd}
          speed = {rxData.speed}
          angle = {rxData.angle}
          */
    }



    }



    
  /* USER CODE END 3 */
}

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
