DasReyxr/RF-Car/code/RX_Car/Core/Inc/main.h

#define RED_Pin GPIO_PIN_13
#define RED_GPIO_Port GPIOC
#define YELLOW_Pin GPIO_PIN_14
#define YELLOW_GPIO_Port GPIOC
#define GREEN_Pin GPIO_PIN_15
#define GREEN_GPIO_Port GPIOC
#define LeftFront_Pin GPIO_PIN_3
#define LeftFront_GPIO_Port GPIOA
#define LeftBack_Pin GPIO_PIN_4
#define LeftBack_GPIO_Port GPIOA
#define RightFront_Pin GPIO_PIN_5
#define RightFront_GPIO_Port GPIOA
#define RightBack_Pin GPIO_PIN_6
#define RightBack_GPIO_Port GPIOA
#define LED_DIR1_Pin GPIO_PIN_0
#define LED_DIR1_GPIO_Port GPIOB
#define LED_DIR2_Pin GPIO_PIN_1
#define LED_DIR2_GPIO_Port GPIOB
#define CSN_Pin GPIO_PIN_8
#define CSN_GPIO_Port GPIOA
#define IRQ_Pin GPIO_PIN_9
#define IRQ_GPIO_Port GPIOA
#define CE_Pin GPIO_PIN_10
#define CE_GPIO_Port GPIOA
#define LUZ_Pin GPIO_PIN_6
#define LUZ_GPIO_Port GPIOB
#define STOP_Pin GPIO_PIN_7
#define STOP_GPIO_Port GPIOB
