DasReyxr/RF-Car/code/RX_Car/Core/Src/conf.c

#include "conf.h"

/*
PINOUT
M1 Left
M2 Right

A Peripherals

PA0 PWM2Ch1
PA1 PWM2Ch2


PA3 M1 Front
PA4 M1 Back

PA5 M2 Front
PA6 M2 Back

PB0 LEDs Left
PB1 LEDs Right

PB5 PWM SERVOMOTOR TIMER3

PA8 CSN
PA9 IRQ
PA10 CE

PB[13:15] SPI
PB13 SCK
PB14 MISO
PB15 MOSI

A2 ADC

B10 TX UART
B11 RX UART

PC13 BATRED
PC14 BATYELL
PC15 BATGREEN

PB6 LUZ
PB7 STOP
1Adc detección de batería 
4Out led direccional/stop/luz
3Out led inducador bateria
1 Uart debbug
1 input reset


*/
#define LED_LEFT 0
#define LED_RIGHT 1
#define LeftFront 3
#define LeftBack 4
#define RightFront 5
#define RightBack 6

// Definir buzer y nrf




/*--- Clase Carro ----*/

    /*
    Valor minimo 200 -45
    Valor maximo 280 +45
    TIM3 servo motor direccion
    TIM2 mmo
    */


    
void CAR_Leds(void){
    /*
    160 - 400
    0     180

    for 45 deg = 220
    for 135 deg = 340
    if(pwm_val > 280) cmd = 0x02; // Right
    if(pwm_val < 280) cmd = 0x03; // Left
    */
    GPIOB->ODR &= ~(3<<0);
    if(TIM3->CCR1 > 280) GPIOB->ODR |= (LED_RIGHT<<0);
    if(TIM3->CCR1 < 280) GPIOB->ODR |= (LED_LEFT<<1);
}


/* Motor Functions */
void CAR_Speed(uint16_t speed){
    if(speed>100)speed=100;
    TIM2->CCR1 = (65535*speed)/100; //DUTYCYCLE 50% CHANEL1
    TIM2->CCR2 = (65535*speed)/100; //DUTYCYCLE 50% CHANEL2
}


void CAR_Front(void){
    GPIOA->ODR &=(0<<RightBack)|(0<<LeftBack);
    GPIOA->ODR |=(1<<RightFront)|(1<<LeftFront);
    
}
void CAR_Back(void){
    GPIOA->ODR &=(0<<RightFront)|(0<<LeftFront);
    GPIOA->ODR |=(1<<RightBack)|(1<<LeftBack);
}

void CAR_Stop(void){
    //GPIOA->ODR &=(0<<RightBack)|(0<<LeftBack)|(0<<RightFront)|(0<<LeftFront);
    //GPIOD->ODR |=(1<<1); //LED STOP
	CAR_Speed(0);
}
/*
angle should varie between -PI/4 to PI/4  (-45 to 45 degrees)

*/
void CAR_Direction(float angle){//HAY QUE LIMITAR EL RANGO DE ANGULOS CON UN IF
    /*
    if(angle < -1*PI/4)
        angle = -PI/4;
    if (angle > PI/4)
        angle = PI/4;

    uint8_t mangol =101 + (uint8_t)(40*angle+20*PI)/PI;

    TIM3->CCR2= (mangol<<1);
*/
    TIM3->CCR2= (uint16_t)angle;
    //mangol;

}

/*----- Configuration -----*/
void confRCC(void){
                /*    IOB,    IOA,   AF*/
    RCC->APB2ENR |= (1<<3)|(1<<2)|(1<<0); // GPIOA GPIOB

    RCC->APB1ENR |= (1<<0) | (1<<1); //TIM2 y TIM3
}
void confGPIO(void){
    //GPIOB
    GPIOB->CRL &= ~(0xF000FF);
    GPIOB->CRL |= (2<<22)|(3<<20)|(3<<4)|(3<<0);
    AFIO->MAPR |= (2<<10);
    //PB4 AF2 TIM3 CH1



}

void confTIMER(void)
{


    /*
    1.25 - 1.75 ms
    Servo
    2 ms 90
    1 ms -90

    20 ms  50hz PERIOD
    8 MHz Prescaler 99 -> 80 KHz
    
    TIM3->ARR  =1599; // 80KHz/50Hz = 1600
    
    */

    TIM3->CCR2= 160;//1600*1.5/20 => 120  7.5% 0°
  //  TIM3->CR1 |= (1<<0);

    /*
    Valor minimo 100 -45
    Valor maximo 140 +45
    */

}


void delay_ms(uint32_t delay){
	for(uint32_t i=0;i<delay;i++){
	for(uint32_t j=0;j<11500;j++);
	}
}


void config(void){
    confRCC();
    confGPIO();
    confTIMER();
    CAR_Speed(50);
}
