DasReyxr/RF-Car/(commit log)

2026-10-10 feat: forked from STM32F-Car
    [6050_MPU_r0.step, Blue_pill.kicad_pcb, Blue_pill.kicad_sch, CARRITOBLPRX.cfg, TAJB226K016RNJ.step, TB6612FNG.step, carro_preliminar.kicad_pcb, carro_preliminar.kicad_sch]
2026-10-10 refactor: Arrange code files
    [CARRITOBLPRX.cfg]
2026-10-10 chore: add git ignore
    [6050_MPU_r0.step, Blue_pill.kicad_pcb, Blue_pill.kicad_sch, CARRITOBLPRX.cfg, TAJB226K016RNJ.step, TB6612FNG.step, carro_preliminar.kicad_pcb, carro_preliminar.kicad_sch]
2026-10-10 feat: TX_Hand one layer WIP unconnected veins
    [6050_MPU_r0.step, Blue_pill.kicad_pcb, Blue_pill.kicad_sch, CARRITOBLPRX.cfg, GY-521.step, TAJB226K016RNJ.step, TB6612FNG.step, TX_Hand.kicad_pcb]
2026-10-10 feat: TX_HAND autoroute try 10-10
    [TX_Hand.kicad_pcb]
2026-10-13 chore: minor fixes
    [RX_RFCAR.kicad_pcb, RX_RFCAR.kicad_sch, TX_Hand.kicad_sch]
2026-10-13 refactor: move design folders
    [6050_MPU_r0.step, Blue_pill.kicad_pcb, Blue_pill.kicad_sch, GY-521.step, RX_RFCAR.kicad_sch, TAJB226K016RNJ.step, TB6612FNG.step, carro_preliminar.kicad_pcb]
2026-10-24 refactor: rearrage schematic
    [RX_RFCAR.kicad_pcb, RX_RFCAR.kicad_sch]
2026-10-24 refactor: change net gnd to simbol gnd
    [RX_RFCAR.kicad_sch]
2026-10-25 fix: merge changes of Ale
    [RX_RFCAR.kicad_sch, TX_Hand.kicad_pcb, TX_Hand.kicad_sch]
2026-10-25 docs: Add STM32F103 Datasheet and Reference Manual
